gretamanerab/CPS---RESPIRA/docs/Research.md

# Respira Research

###   1. Literary Review: Breathing and human physiological response to stress

Research by Homma and Masaoka (2008) explores the relationship between respiratory rhythms and emotional states, while Russo et al. (2017) review the physiological mechanisms associated with slow breathing. Research suggests that voluntarily slowing breathing can influence cardiovascular regulation, particularly heart rate variability (HRV).

HRV describes variations in the time intervals between consecutive heartbeats and is commonly used to investigate autonomic regulation. Russo et al. (2017) identify approximately six breaths per minute as a particularly relevant breathing frequency for cardiovascular effects. At this rate, respiratory and cardiovascular rhythms interact, potentially increasing heart rate variability.

Similarly, Shao et al. (2024) reviewed 31 studies involving 1,133 participants. Their findings indicated improvements in several cardiovascular measures following slow-paced breathing, although evidence for reductions in negative emotions was less conclusive.

#### Human Breathing patterns and Respira physiological targets

| Feature | Under stress | Goal |
|---|---|---|
| Breathing rate | Often increases | 6 breaths per minute |
| Inhale to exhale ratio | Exhale becomes relatively shorter | Longer exhalation than inhalation (e.g. 1:2) |
| Exhale duration | Often shortened | Extended with a gradual and controlled release |
| Breath-to-breath variability | May become irregular or altered | Consistent and rhythmic breathing |
| Breath depth | Shallower | Controlled |

###   2. Body Mimetics and Biofeedback

Humans are mimetic beings, capable of synchronising body movement to external cues. This can be observed in everyday situations: people walking together may unconsciously adjust their pace to match one another, while listeners often tap their feet or move their bodies in time with music. These examples demonstrate how external rhythms can influence and coordinate human bodily movements to external cues.

Could this mechanism be utilized as a means to facilitate breathing rhythm transitions?

Biofeedback refers to the process of making physiological information available to an individual, allowing them to become more aware of and potentially regulate their bodily responses. Venkat et al. (2008), for example, developed an audiovisual respiratory biofeedback system that translated participants' respiratory waveforms into visual and auditory cues. Their study explored how different forms of feedback, including wave and bar representations, could support respiratory awareness and paced breathing.

Building on these principles, Respira explores the relationship between bodily synchronisation and respiratory biofeedback. Rather than immediately instructing visitors to change their breathing, the installation initially mirrors their existing rhythm before gradually introducing a slower pace. Through this transition from mirroring to pacing, Respira investigates whether an external, responsive stimulus can encourage visitors to adjust their breathing through natural processes of synchronisation, potentially supporting momentary stress regulation.

###   3. Bubble Anatomy and Morphogenesis

A soap bubble is a thin liquid film consisting of a layer of water stabilised by surfactant molecules at its two air–water interfaces. Surfactants, commonly found in soap and detergents, are amphiphilic molecules composed of hydrophilic (water-attracting) heads and hydrophobic (water-repelling) tails.

<p align="center">
Screenshot 2026-11-09 at 1 11 57 PM
</p>

At the air–water interface, these molecules orient themselves with their hydrophilic heads towards the water and their hydrophobic tails towards the surrounding air. This arrangement reduces the surface tension of water, allowing it to stretch into a thin, flexible film capable of enclosing air (Gibbs, Bubble and Foam Chemistry).

<p align="center">
Screenshot 2026-11-09 at 1 13 36 PM
</p>

Surface tension originates from the cohesive forces between water molecules. Molecules within the bulk liquid experience approximately balanced intermolecular forces, whereas molecules at the surface experience an imbalance, producing a tendency to minimise the surface area. The addition of surfactants modifies this behavior by reducing surface tension and introducing interfacial forces that help stabilize the film. When the film is locally stretched and its surfactant concentration changes, variations in surface tension generate Marangoni flows, which redistribute liquid and surfactants along the interface. This mechanism helps resist film thinning. and contributes to bubble stability (Interfacial Mechanisms for Stability of Surfactant-Laden Films, 2017; Cantat et al., 2026).

The spherical geometry of a free-floating soap bubble is a consequence of surface-energy minimisation. For a fixed volume of enclosed air, a sphere encloses the maximum volume with the minimum possible surface area. Since surface tension drives the film towards a configuration of lower surface energy, the bubble naturally adopts a spherical form. This makes soap bubbles an example of minimal-surface geometry, in which physical systems organize themselves into configurations that minimize energy (Préve & Saa, 2015; On the Shape of Giant Soap Bubbles, 2017). However, external forces such as gravity, airflow and contact with surrounding surfaces can deform this ideal geometry. A further example of minimal-surface geometry is the catenoid, a surface formed when a soap film spans two parallel, coaxial circular rings. The film adopts an hourglass-like geometry, narrowing towards the centre and widening towards the supporting rings. If the rings are too far apart, the catenoid becomes unstable and snaps into two separate disks. The critical separation for equal rings is approximately 0.663 times the ring diameter. For a spherical bubble, the two radii are equal. Soap bubbles are inherently unstable structures, and their lifetime depends on the physical and environmental conditions surrounding them. Over time, gravity causes liquid to drain towards the lower regions of the film, while evaporation progressively reduces its thickness. Air currents, mechanical contact and local variations in film thickness can further destabilise the structure, eventually causing it to rupture. The stability of a bubble is influenced by the composition of its solution, particularly its surfactant concentration and the presence of additives. Beyond their visual qualities, soap bubbles demonstrate how complex forms can emerge from relatively simple physical principles. Their geometry, movement, color and eventual rupture are not predetermined, but continuously shaped by the interaction between surface tension, gravity, fluid dynamics, light and environmental conditions. In this sense, the bubble can be understood as an example of nature's form-finding processes: a structure that continuously responds to its environment while seeking physical equilibrium.

###   4. Bubble as a Design Informant through Time 

Several interactive art and design projects have explored soap bubbles as a medium for translating otherwise invisible phenomena into physical, temporary forms. Frei Otto was a German architect and structural engineer renowned for pioneering lightweight tensile architecture. His work explored how natural physical processes, such as soap bubbles, could inform the development of efficient architectural structures, minimizing material use while maximizing structural performance (Pritzker Architecture Prize, 2015). By suspending soap films within different wire and string boundaries, Otto observed how surface tension naturally generated minimal surfaces.

<p align="center">
80dc7011ea2714dbc88678e08c1966aa
</p>

Two relevant precedents of more contemporary design practises utilizing bubbles are Thom Kubli's Black Hole Horizon (2012–2015) and Yasuaki Kakehi and collaborators' Air on Air (2020).

Thom Kubli, Black Hole Horizon (2012–2015)

<p align="center">
Screenshot 2026-11-09 at 1 18 33 PM
</p>

<p align="center">
g7wI8P-TuHvo7YYZLUPgfDbHv880lJ_TqNQtvV5sjTJWebuJeuAhrQi1Ir-rRXHNHwBaEfjLNE3QsKa803gdg9_rb258JSxWar2f4FIMYMpiE6mx5jg-HXGt-Iwy62-XFWn2YGdA9s0nSsq5CFbOKstm0A7stZ3PWRsp2QMvODc
</p>

In Black Hole Horizon, sound is translated into the physical formation of soap bubbles. The bubbles grow in proportion to the duration of the sound, detach from the horns and float through the gallery before eventually bursting. This project demonstrates how an invisible phenomenon can be translated into a tangible, temporary physical form.

Yasuaki Kakehi and collaborators, Air on Air (2020)

<p align="center">
Screenshot 2026-11-09 at 1 19 33 PM
</p>

Air on Air connects participants in different locations through their breath. Participants blow into a microphone, transmitting their breath as data over the internet. A bubble-generating machine at a distant location then produces bubbles in response to the strength and duration of the transmitted breath. This project demonstrates how breathing can be captured as input and translated into a physical bubble-based output. Respira develops this relationship further by exploring not only the representation of breath, but also the possibility of influencing its rhythm through a responsive interaction.

## References

Balban, M. Y., et al. “Brief Structured Respiration Practices Enhance Mood and Reduce Physiological Arousal.” *Cell Reports Medicine* 4, no. 1 (2023): 100895. [https://doi.org/10.1016/j.xcrm.2022.100895](https://doi.org/10.1016/j.xcrm.2022.100895).

Bhamla, M. S., C. Chai, M. A. Álvarez-Valenzuela, J. Tajuelo, and G. G. Fuller. “Interfacial Mechanisms for Stability of Surfactant-Laden Films.” *PLOS ONE* 12, no. 5 (2017): e0175753. [https://doi.org/10.1371/journal.pone.0175753](https://doi.org/10.1371/journal.pone.0175753).

“Breathing Metrics for Stress Detection and Guided Breathing.” Background Research and Sensor Comparison. Claude Artifact. [https://claude.ai/artifact/WgDdvaBqwFZTfhzFZooab7](https://claude.ai/artifact/WgDdvaBqwFZTfhzFZooab7).

Cantat, I., S. Pertant, C. Raufaste, and E. Rio. “Capillary Drainage in Horizontal Soap Films: Theoretical Review and Experimental Illustrations.” *Annual Review of Fluid Mechanics* 58 (2026): 111–38. [https://doi.org/10.1146/annurev-fluid-100224-111138](https://doi.org/10.1146/annurev-fluid-100224-111138).

Cohen, C., B. Darbois Texier, E. Reyssat, J. H. Snoeijer, D. Quéré, and C. Clanet. “On the Shape of Giant Soap Bubbles.” *Proceedings of the National Academy of Sciences* 114, no. 10 (2017): 2515–19. [https://doi.org/10.1073/pnas.1612188114](https://doi.org/10.1073/pnas.1612188114).

“Development and Pilot Test of a Virtual Reality Respiratory Biofeedback Approach.” (2020). [https://doi.org/10.1007/s10484-020-09468-x](https://doi.org/10.1007/s10484-020-09468-x).

Fiebrink, Rebecca. *Wekinator*. Software and project website. [https://www.wekinator.org/](https://www.wekinator.org/).

Franco, José Tomás. “Frei Otto Experimenting with Soap Bubbles.” *ArchDaily*, 2015. [https://www.archdaily.com/609541/video-frei-otto-experimenting-with-soap-bubbles](https://www.archdaily.com/609541/video-frei-otto-experimenting-with-soap-bubbles).

Grassmann, M., et al. “Respiratory Changes in Response to Cognitive Load: A Systematic Review.” *Neural Plasticity* 2016 (2016): 8146809. [https://doi.org/10.1155/2016/8146809](https://doi.org/10.1155/2016/8146809).

Homma, I., and Y. Masaoka. “Breathing Rhythms and Emotions.” *Experimental Physiology* 93, no. 9 (2008): 1011–21. [https://doi.org/10.1113/expphysiol.2008.042424](https://doi.org/10.1113/expphysiol.2008.042424).

Kakehi, Y., et al. *Air on Air*. Ars Electronica Festival, 2020.

Kawashima, R., and Y. Kakehi. *Anima – Breathing Life Into a Light*. Material Experience Design Laboratory, University of Tokyo, 2018.

Laborde, S., et al. “Effects of Voluntary Slow Breathing on Heart Rate and Heart Rate Variability: A Systematic Review and a Meta-Analysis.” *Neuroscience & Biobehavioral Reviews* 138 (2022): 104711. [https://doi.org/10.1016/j.neubiorev.2022.104711](https://doi.org/10.1016/j.neubiorev.2022.104711).

Marteau, T. M., and H. Bekker. “The Development of a Six-Item Short Form of the State Scale of the STAI.” *British Journal of Clinical Psychology* 31, no. 3 (1992): 301–6. [https://doi.org/10.1111/j.2044-8260.1992.tb00997.x](https://doi.org/10.1111/j.2044-8260.1992.tb00997.x).

Masaoka, Y., and I. Homma. “Anxiety and Respiratory Patterns: Their Relationship during Mental Stress and Physical Load.” *International Journal of Psychophysiology* 27, no. 2 (1997): 153–59. [https://doi.org/10.1016/S0167-8760(97)00052-4](https://doi.org/10.1016/S0167-8760(97)00052-4).

OpenStax. *University Physics, Volume 3: Interference in Thin Films*. Rice University, 2016. [https://openstax.org/books/university-physics-volume-3/pages/3-4-interference-in-thin-films](https://openstax.org/books/university-physics-volume-3/pages/3-4-interference-in-thin-films).

Pasquet, M., F. Boulogne, F. Restagno, and E. Rio. “Lifetime of Vertical Giant Soap Films: Role of the Relative Humidity and Film Dimensions.” *Soft Matter* 20 (2024): 2374–80. [https://doi.org/10.1039/D3SM01629C](https://doi.org/10.1039/D3SM01629C).

Préve, D., and A. Saa. “Doughnut-Shaped Soap Bubbles.” *Physical Review E* 92 (2015): 042402. [https://doi.org/10.1103/PhysRevE.92.042402](https://doi.org/10.1103/PhysRevE.92.042402).

Pugh, R. J. “Soap Bubbles and Thin Films.” In *Bubble and Foam Chemistry*, 84–111. Cambridge: Cambridge University Press, 2016. [https://doi.org/10.1017/CBO9781316106938.004](https://doi.org/10.1017/CBO9781316106938.004).

Russo, M. A., D. M. Santarelli, and D. O’Rourke. “The Physiological Effects of Slow Breathing in the Healthy Human.” *Breathe* 13, no. 4 (2017): 298–309. [https://doi.org/10.1183/20734735.009817](https://doi.org/10.1183/20734735.009817).

Schmidt, P., et al. “Introducing WESAD, a Multimodal Dataset for Wearable Stress and Affect Detection.” In *Proceedings of the 2018 ACM International Conference on Multimodal Interaction (ICMI 2018)* (2018). [https://doi.org/10.1145/3242969.3242985](https://doi.org/10.1145/3242969.3242985).

Shao, R., I. S. C. Man, and T. M. C. Lee. “The Effect of Slow-Paced Breathing on Cardiovascular and Emotion Functions: A Meta-Analysis and Systematic Review.” *Mindfulness* 15 (2024): 1–18.

Venkat, R. B., et al. “Development and Preliminary Evaluation of a Prototype Audiovisual Biofeedback Device Incorporating a Patient-Specific Guiding Waveform.” *Physics in Medicine & Biology* 53 (2008): N197. [https://doi.org/10.1088/0031-9155/53/11/N01](https://doi.org/10.1088/0031-9155/53/11/N01).
