gretamanerab/CPS---RESPIRA/hardware/Bills_of_Materials_BOM.md

# Bill of Materials (BOM)

This document lists the electronic components used in the Respira system, including their technical specifications, quantities and functions.

## Electronic Components

| Component | Specification | Quantity | Function |
|---|---|---:|---|
| Arduino | Arduino Nano| 1 | Microcontroller for sensor acquisition and motor control |
| Servo motor | 28BYJ-48 5V Stepper Motor | 4 | Drives the mechanical bubble-forming mechanism |
| USB cable | Data-enabled | 1 | Serial communication and Arduino programming |
| Power supply | 5v | 1 | Supplies the electronic and mechanical system |
| LED strip | Model and voltage to confirm | 1 | Bubble illumination |
| Jumper wires | Male-to-male / other types | TBD | Electrical connections |
| Breadboard / prototyping board | // | 4 | Circuit assembly |
| NTC thermistor | 100K, Beta 3950 | 2 | Experimental breathing temperature measurement |
| Fixed resistor | 100kΩ | 2 | Thermistor voltage dividers |
| Ultrasonic sensor | HC-SR04 | 2 | Experimental chest/belly displacement measurement |
