gretamanerab/CPS---RESPIRA/mechanical/BreathDevice.step

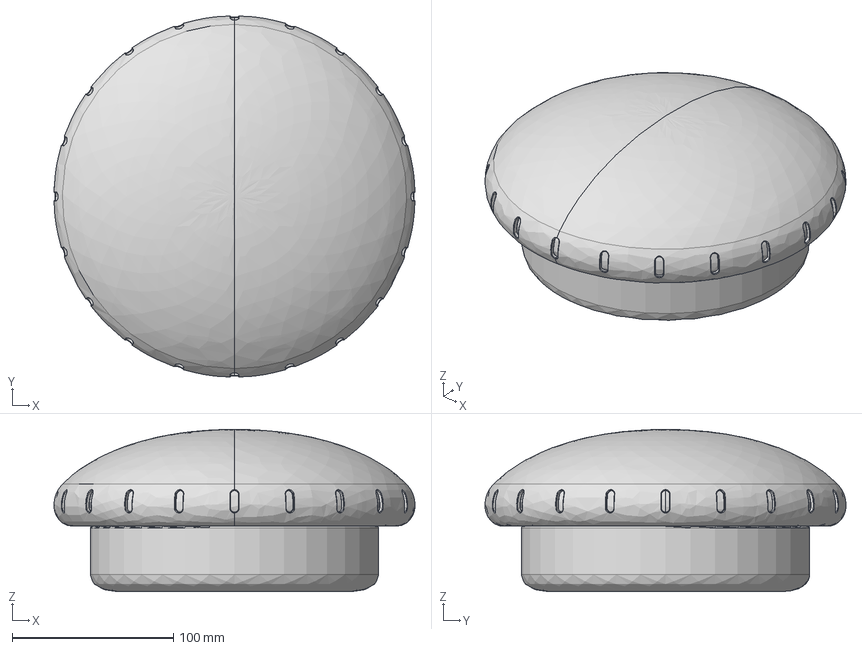
[picture p1: CAD file, 2026-11-14]
mechanical/BreathDevice.step
223.8 x 223.8 x 100.5 mm
Metal Rod x 2
Wires x 2
