gretamanerab/CPS---RESPIRA/mechanical/Cable Holder 2.pdf

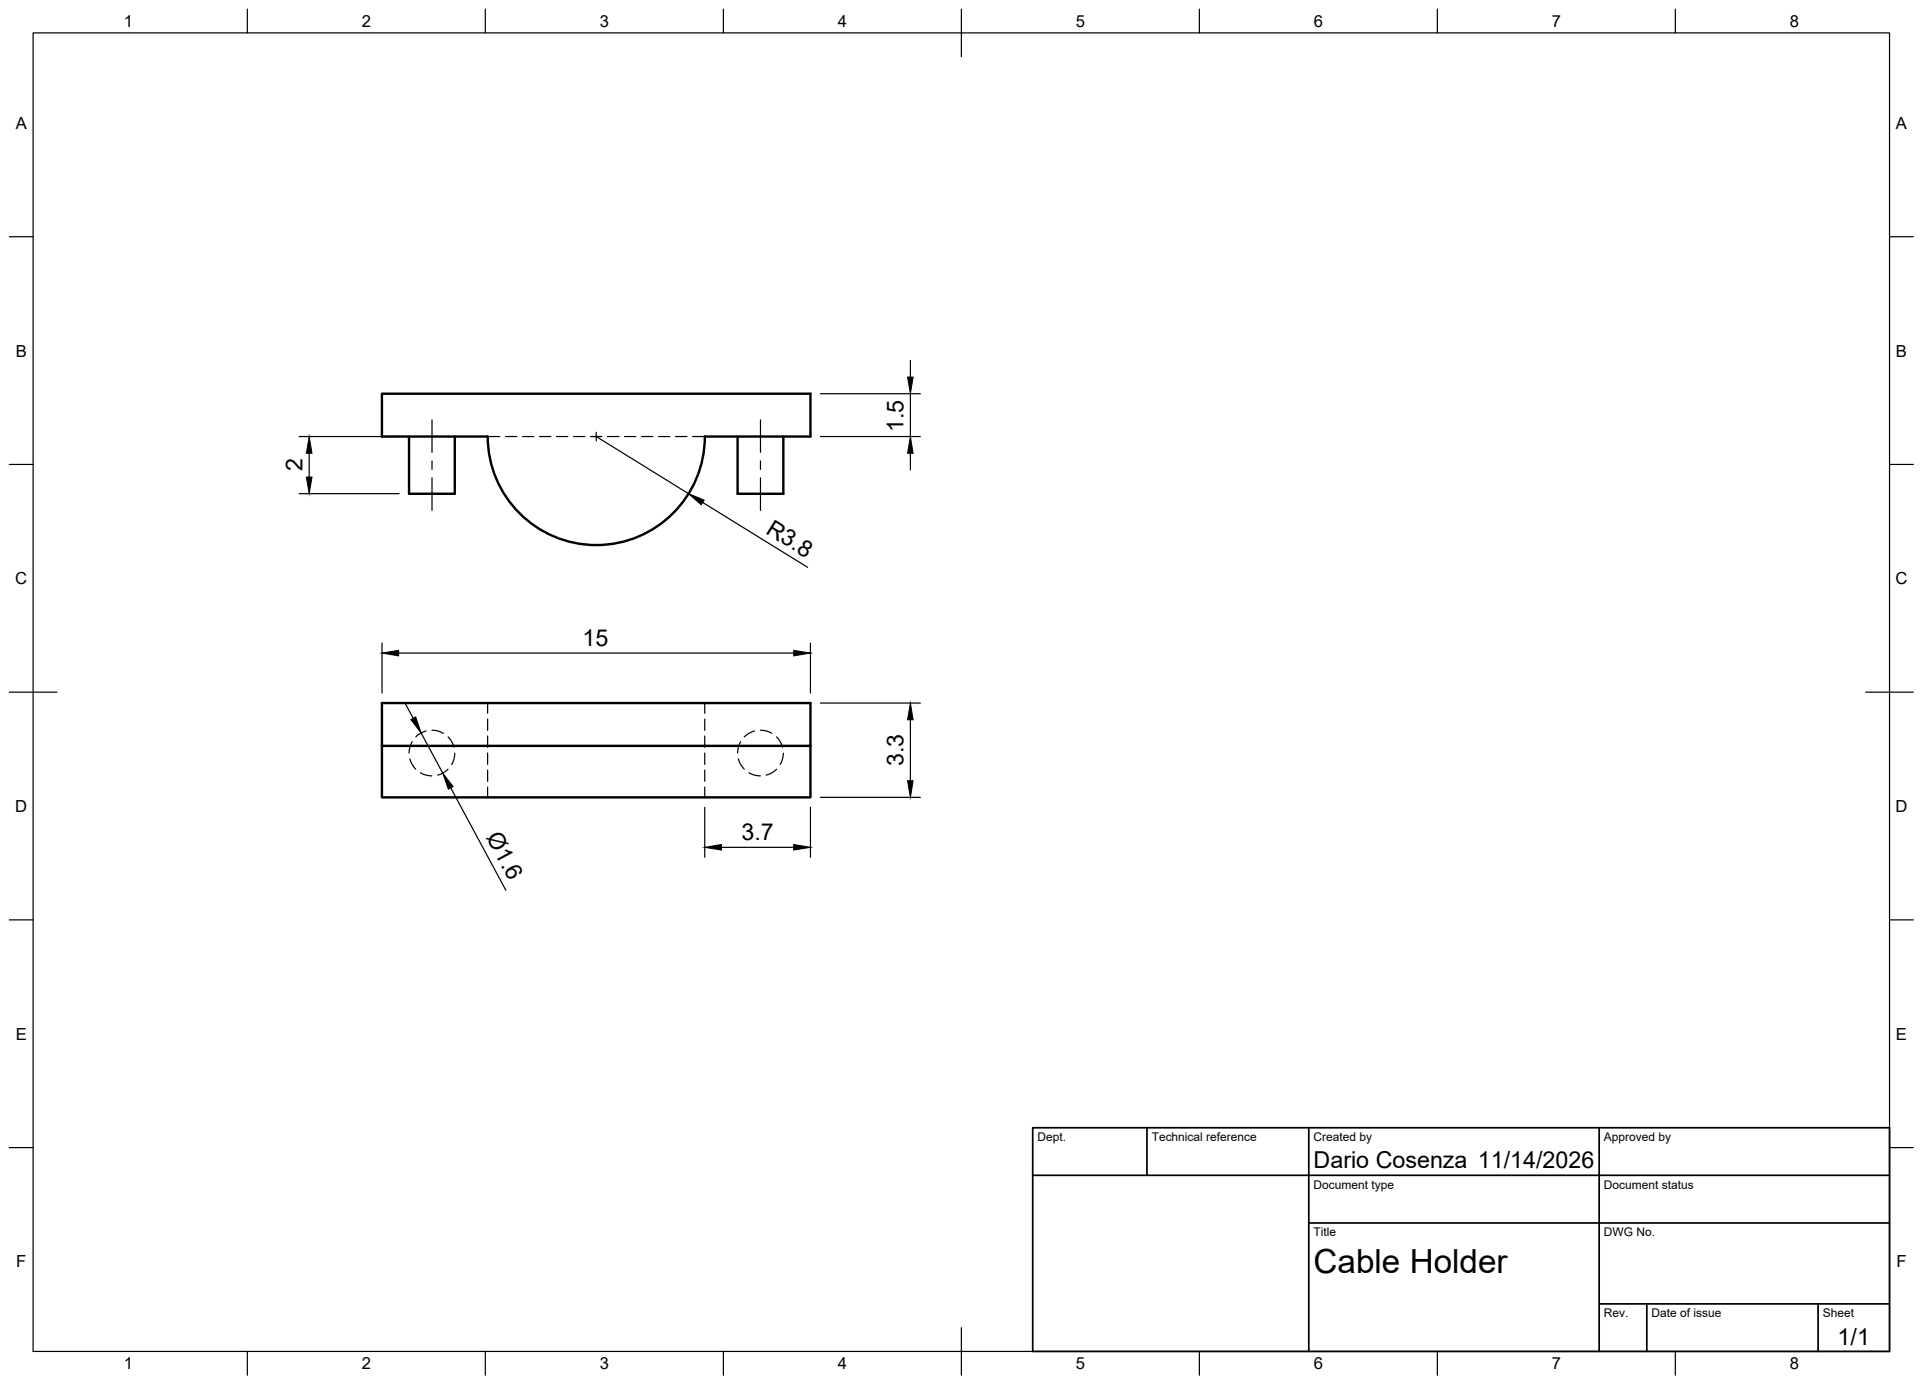
[picture p5: page 1]
Title; DWG No.; Rev.; Date of issue; Sheet; Cable Holder; Dario Cosenza 1.5

Dept. | Technical reference | Created by 11/14/2026 | Approved by

Document type | Document status
