gretamanerab/CPS---RESPIRA/mechanical/Calbe Holder 1.pdf

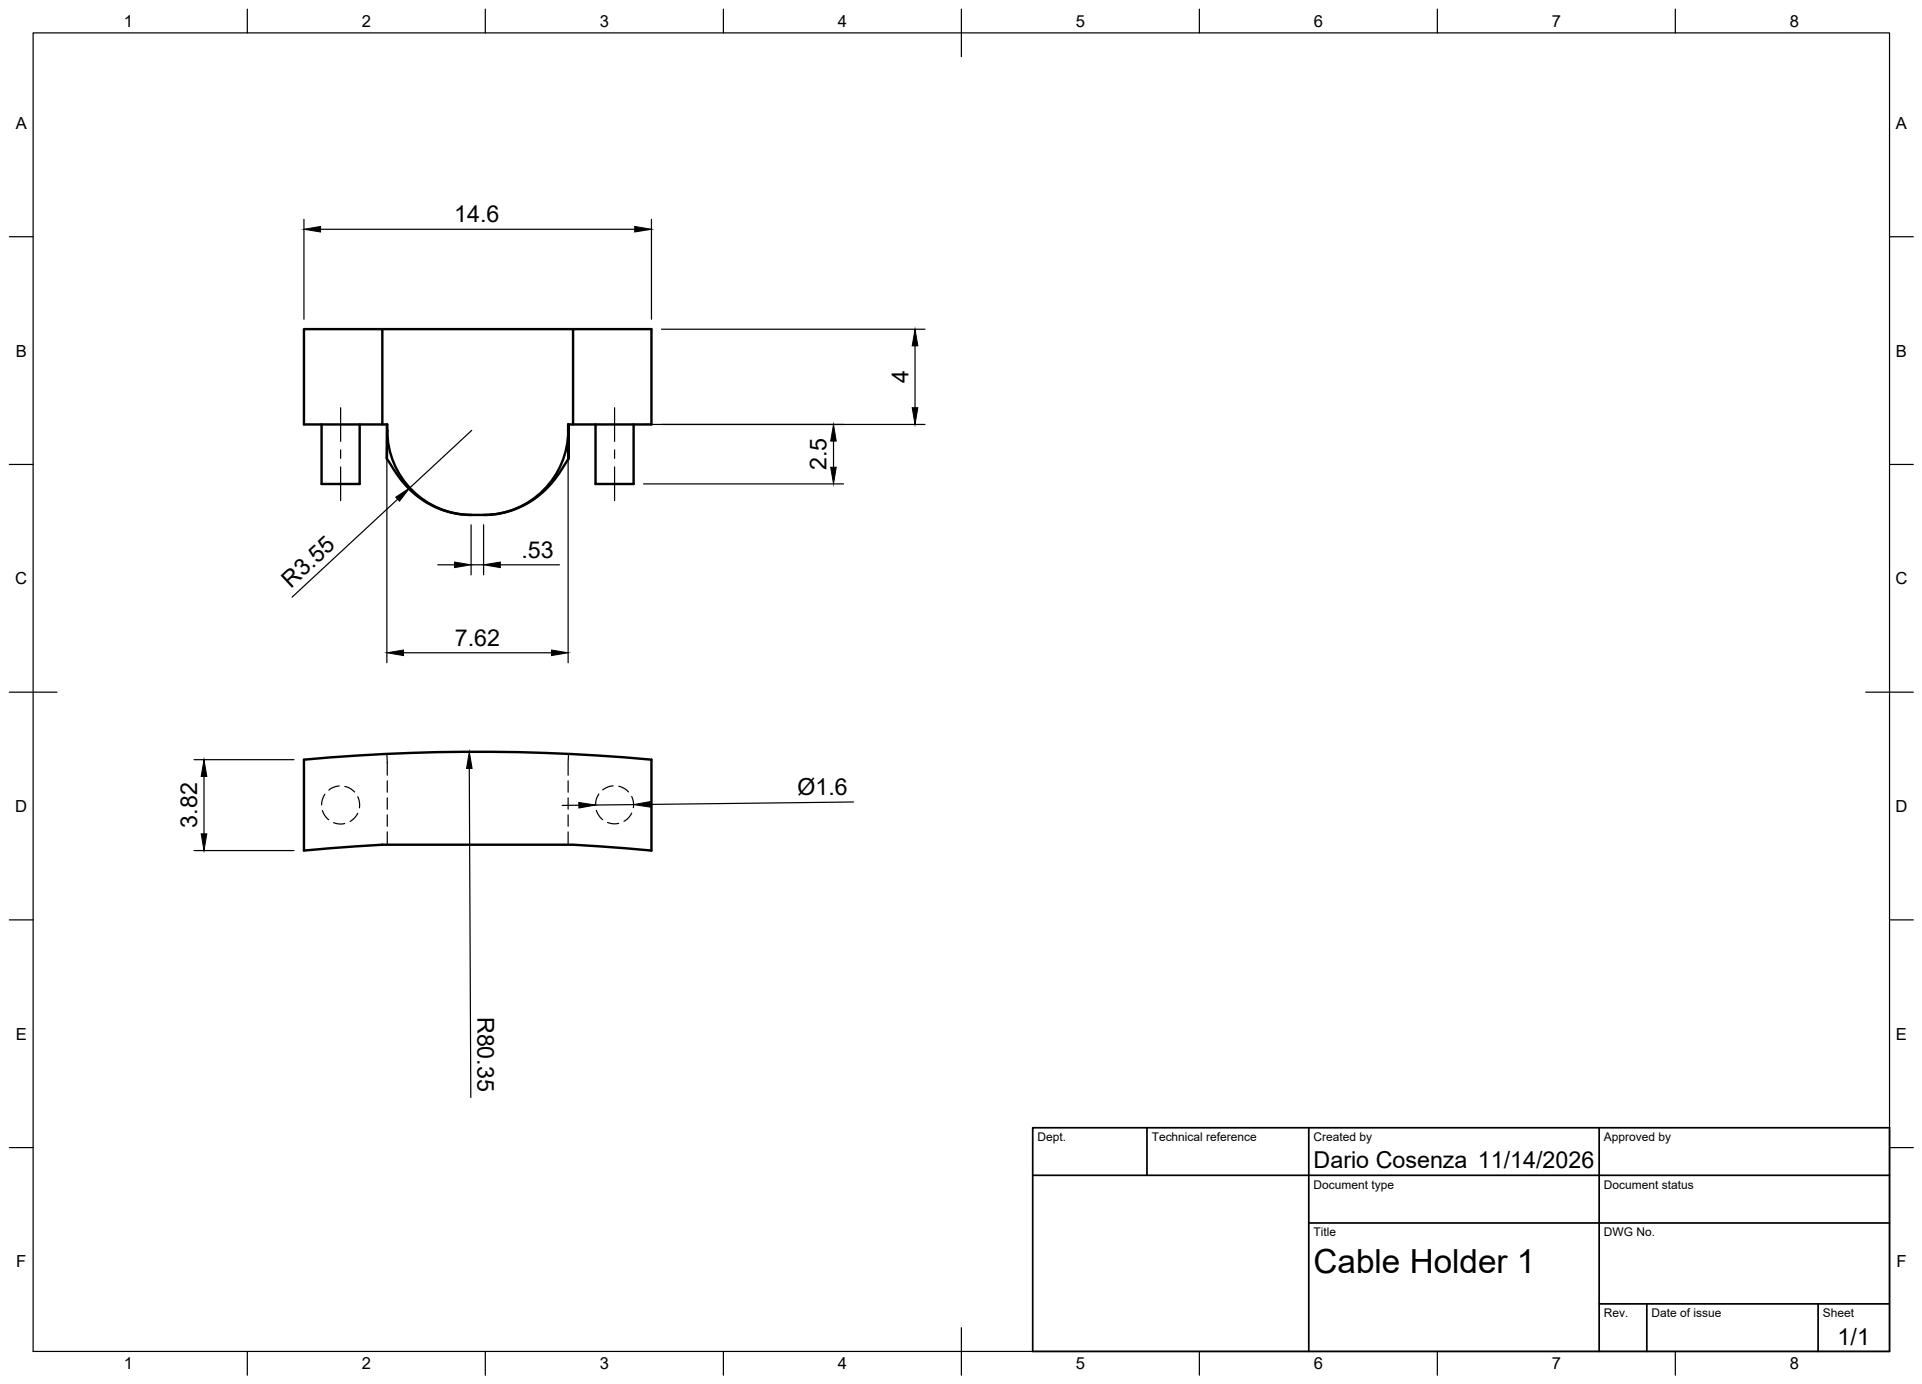
[picture p6: page 1]
Title; DWG No.; Rev.; Date of issue; Sheet; Cable Holder 1

Dept. | Technical reference | Created by Dario Cosenza 11/14/2026 | Approved by

Document type | Document status
