gretamanerab/CPS---RESPIRA/mechanical/Air Locker.pdf

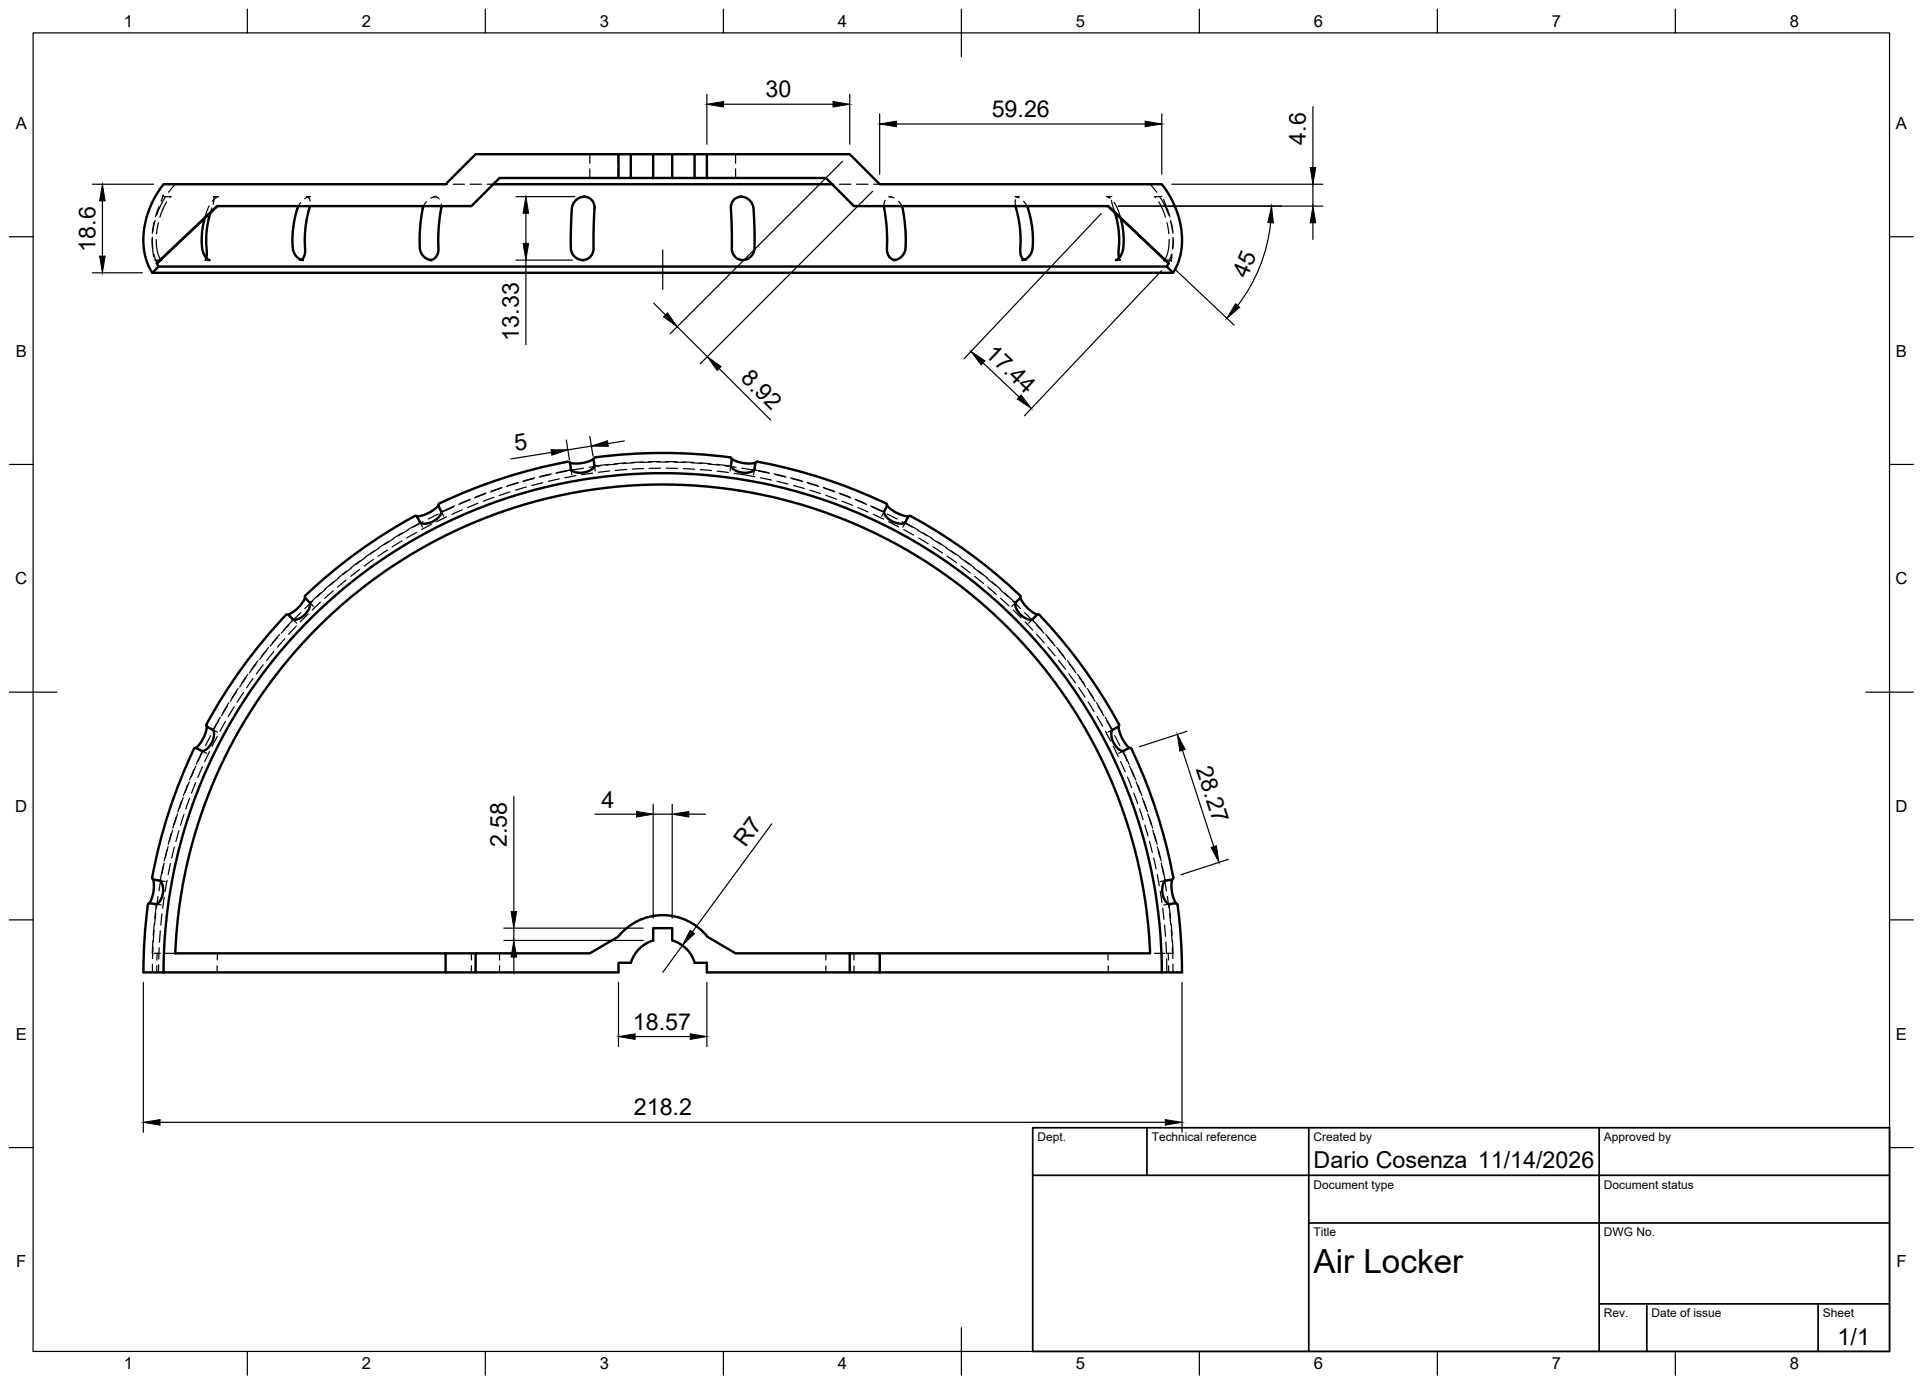
[picture p7: page 1]
Title; DWG No.; Rev.; Date of issue; Sheet; Air Locker

Dept. | Technical reference | Created by Dario Cosenza 11/14/2026 | Approved by

Document type | Document status
