gretamanerab/CPS---RESPIRA/mechanical/Base.pdf

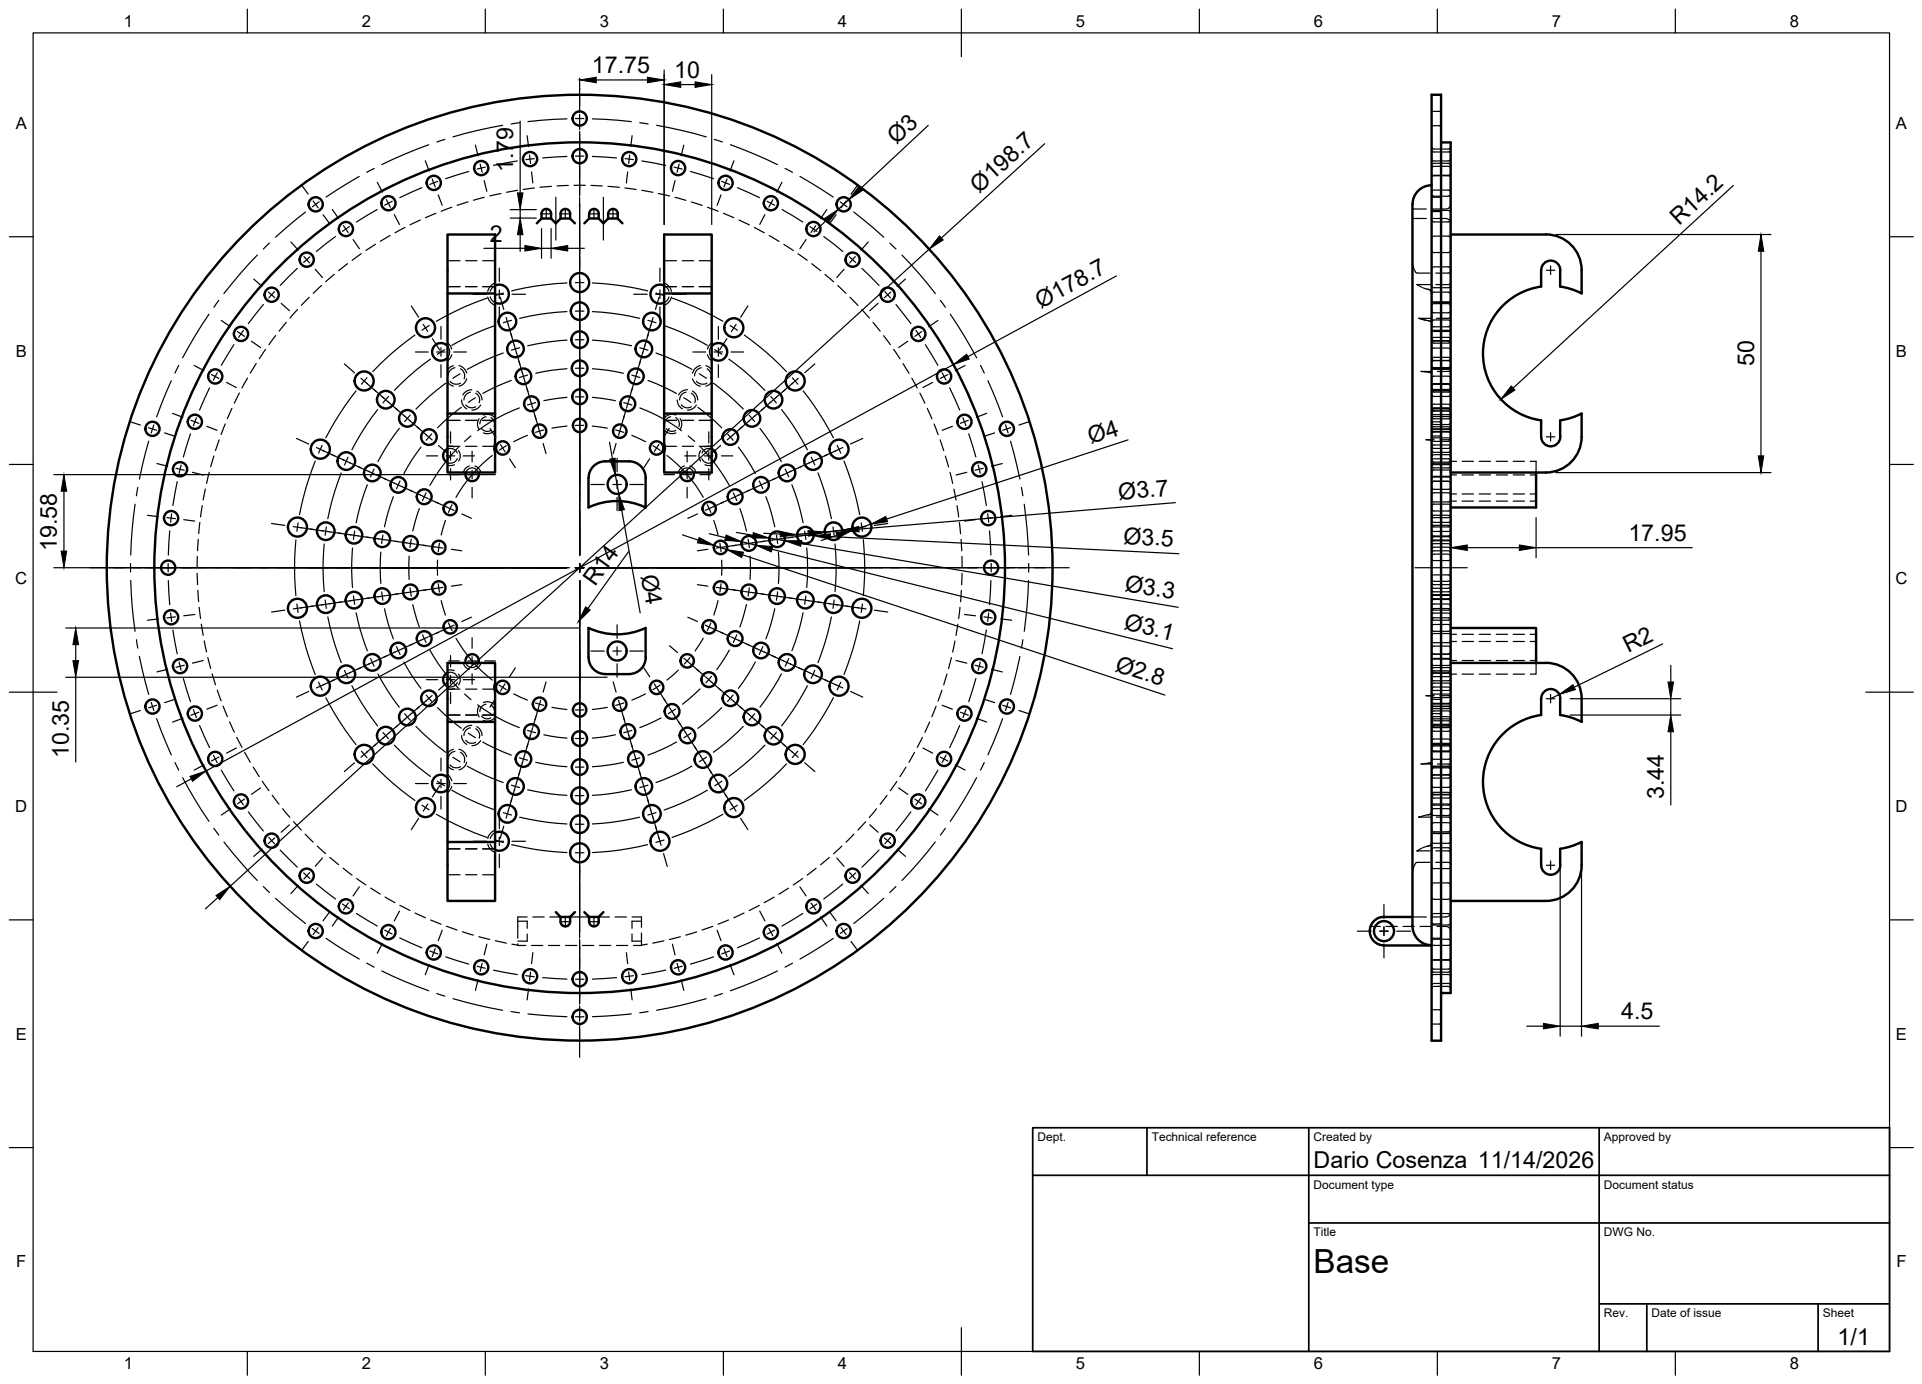
[picture p8: page 1]
8 BCDEF; ABCDEF; Title; DWG No.; Rev.; Date of issue; Sheet

Dept. | Technical reference | Created by Dario Cosenza 11/14/2026 | Approved by

Document type | Document status
