gretamanerab/CPS---RESPIRA/mechanical/Half RIng.pdf

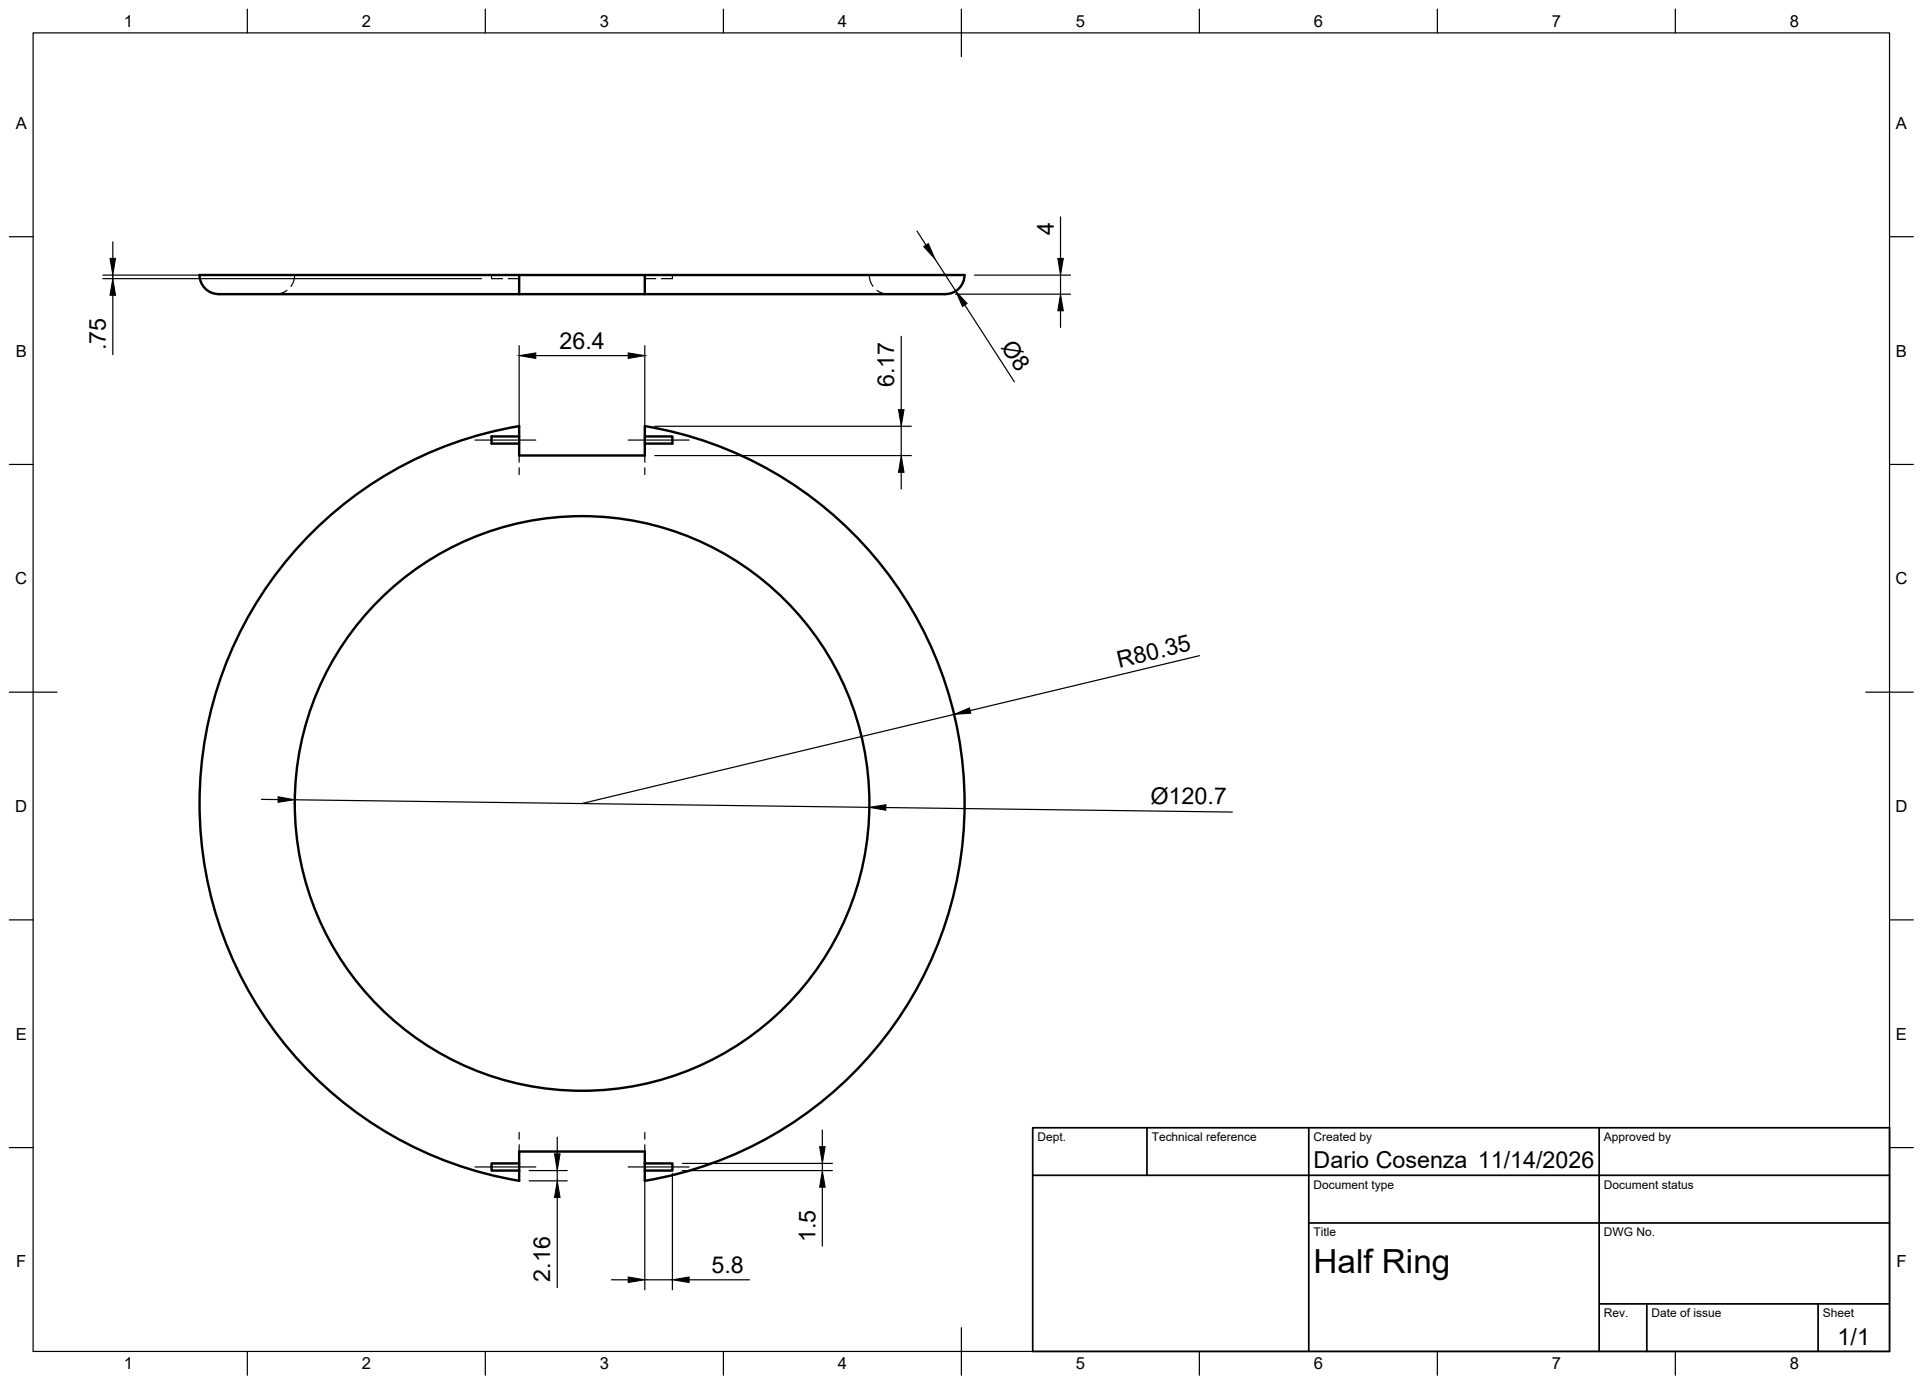
[picture p9: page 1]
Title; DWG No.; Rev.; Date of issue; Sheet; Half Ring

Dept. | Technical reference | Created by Dario Cosenza 11/14/2026 | Approved by

Document type | Document status
