gretamanerab/CPS---RESPIRA/mechanical/Head.pdf

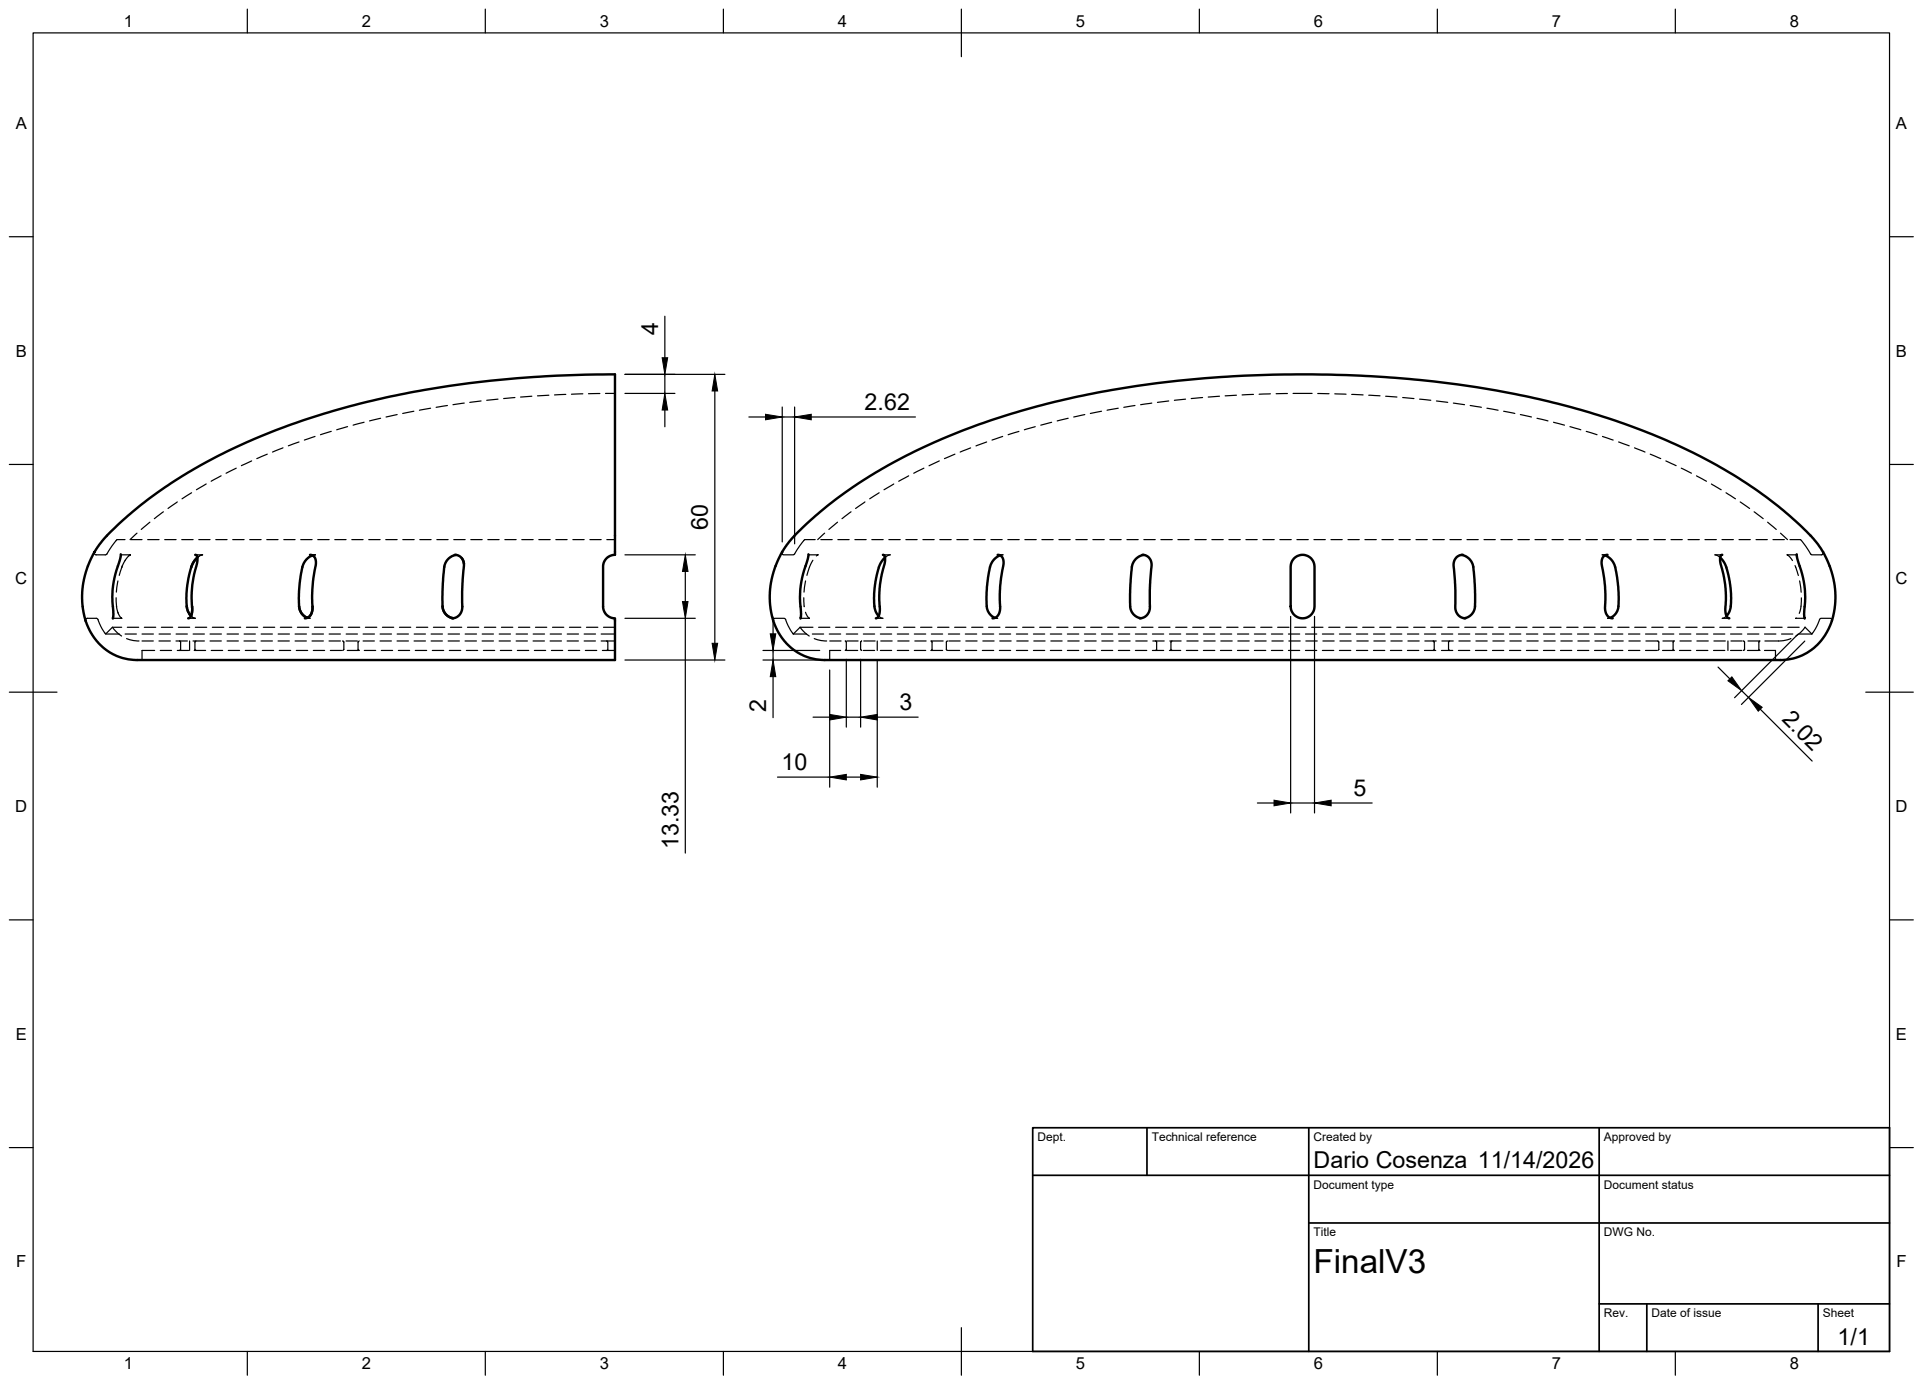
[picture p10: page 1]
Title; DWG No.; Rev.; Date of issue; Sheet; Dario Cosenza 60 13.33

Dept. | Technical reference | Created by 11/14/2026 | Approved by

Document type | Document status
