gretamanerab/CPS---RESPIRA/(commit log)

2026-11-08 Update title of thermistor wiring documentation
2026-11-08 Add thermistor wiring test documentation
2026-11-08 Add subsection for failed mechanical prototypes
2026-11-09 Enhance user experience section in README
    Added detailed description of user experience stages in the README.
2026-11-09 Fix formatting in user experience stages section
    Updated the formatting of the user experience stages in the README.
2026-11-09 Add new code examples for Arduino and sensors
2026-11-09 Add hardware documentation including schematics and BOM
    Added various documentation for hardware components.
2026-11-09 Add test for ultrasonic wiring
2026-11-09 Add Arduino sketch for dual ultrasonic sensors
2026-11-09 Add Bill of Materials (BOM) for Respira system
    This document lists the electronic components used in the Respira system, including their specifications, quantities, and functions.
2026-11-09 Add Bill of Materials for Respira system
    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
2026-11-09 Add motor circuit documentation for 28BYJ-48
    Document the stepper motor circuit setup, including motor specifications, electrical connections, and circuit diagram.
2026-11-14 Include flowchart for visitor interaction process
    Added flowchart to illustrate the visitor interaction process with the installation.
2026-11-14 Insert system architecture diagram in README
    Added a diagram to illustrate system architecture.
2026-11-14 Fix heading format in Assembly_md
2026-11-14 Fix filename typo for Assembly.md
2026-11-14 Revise BOM with updated servo motor quantity
    Updated the quantity of the servo motor from 1 to 4 and removed the sensor testing components section along with associated notes.
2026-11-14 Update specifications for Arduino and Servo motor
